zubon2003/c5-fpga-hdmi/hardware/tang25k_base/preview.png

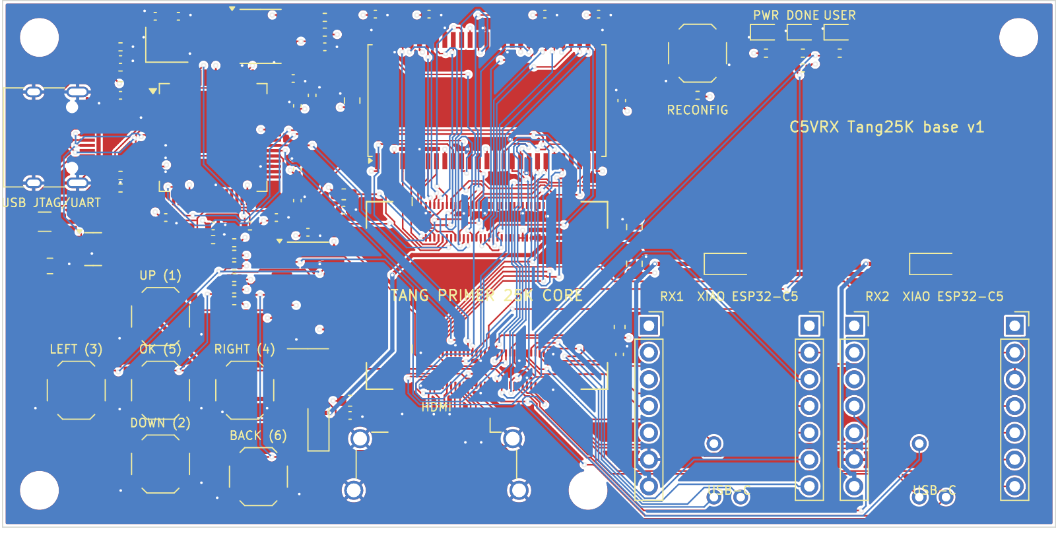
hardware/tang25k_base/preview.png
