zubon2003/c5-fpga-hdmi/hardware/tang25k_base/jlcpcb/tang25k_base_bom.csv

Comment | Designator | Footprint | LCSC
22uF | C1,C2 | C_0805_2012Metric | C45783
100nF | C3,C4,C5,C10,C11,C12,C13,C15,C23,C25,C26,C27,C28,C29,C30,C32,C33 | C_0402_1005Metric | C1525
10uF | C6,C14 | C_0805_2012Metric | C15850
27pF | C20,C21 | C_0402_1005Metric | C1557
4.7uF | C22,C24,C31 | C_0402_1005Metric | C23733
RB160M-30 | D1,D2,D3 | D_SOD-123 | C323857
green | D10,D11,D12 | LED_0603_1608Metric | C72043
1.5A PTC | F1 | Fuse_1206_3216Metric | C20802
600R@100MHz | FB1,FB2,FB3,FB4 | L_0603_1608Metric | C1015
DF40C-60DS-0.4V(51) | J1,J2 | Hirose_DF40C-60DS-0.4V_2x30_P0.4mm | C597938
TYPE-C-31-M-12 | J3 | USB_C_Receptacle_HRO_TYPE-C-31-M-12 | C165948
HDMI A | J4 | HDMI_A_Amphenol_10029449-x01xLF_Horizontal | C427307
5.1k | R1,R2,R5 | R_0402_1005Metric | C25905
12k 1% | R3 | R_0402_1005Metric | C25752
10k | R4,R7,R10,R11,R12,R13,R14,R15,R16,R22 | R_0402_1005Metric | C25744
2.2k | R6 | R_0402_1005Metric | C25879
1k | R20,R21,R23 | R_0402_1005Metric | C11702
TS-1187A | SW1,SW2,SW3,SW4,SW5,SW6,SW7 | SW_Push_1P1T_XKB_TS-1187A | C318884
FT2232HL | U1 | LQFP-64_10x10mm_P0.5mm | C27882
93LC56B | U2 | SOIC-8_3.9x4.9mm_P1.27mm | C183620
W9825G6KH-6I | U3 | TSOP-II-54_22.2x10.16mm_P0.8mm | C97572
74HC165 | U4 | SOIC-16_3.9x9.9mm_P1.27mm | C5613
USBLC6-2SC6 | U6 | SOT-23-6 | C7519
12MHz | Y1 | Crystal_SMD_3225-4Pin_3.2x2.5mm | C9002
