zubon2003/c5-fpga-hdmi/hardware/tang_primer_25k_dock_dimensions.pdf

## Tang Primer 25K Dock（60033）外形・取付穴

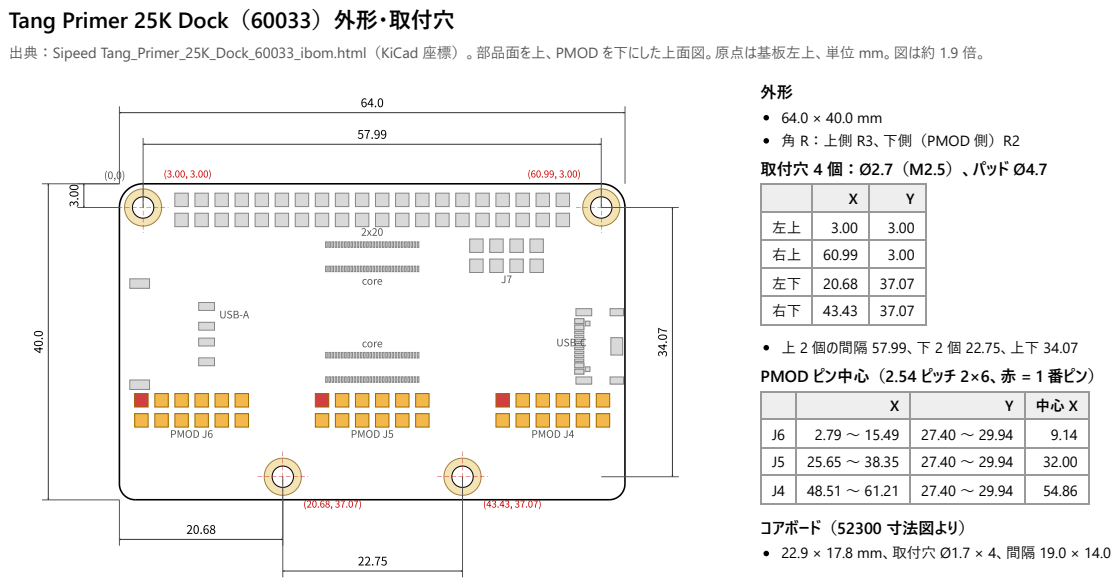
[picture p2: page 1]
core; PMOD J5; USB-C; PMOD J6; PMOD J4; USB-A

出典：Sipeed Tang_Primer_25K_Dock_60033_ibom.html（KiCad 座標）。部品面を上、PMOD を下にした上面図。原点は基板左上、単位 mm。図は約 1.9 倍。

角 R：上側 R3、下側（PMOD 側）R2
取付穴 4 個：Ø2.7（M2.5）、パッド Ø4.7

左上 | 3.00 | 3.00
右上 | 60.99 | 3.00
左下 | 20.68 | 37.07
右下 | 43.43 | 37.07

上 2 個の間隔 57.99、下 2 個 22.75、上下 34.07
PMOD ピン中心（2.54 ピッチ 2×6、赤 = 1 番ピン）

J6 | 2.79 〜 15.49 | 27.40 〜 29.94 | 9.14
J5 | 25.65 〜 38.35 | 27.40 〜 29.94 | 32.00
J4 | 48.51 〜 61.21 | 27.40 〜 29.94 | 54.86

コアボード（52300 寸法図より）
22.9 × 17.8 mm、取付穴 Ø1.7 × 4、間隔 19.0 × 14.0
