zubon2003/c5-fpga-hdmi/hardware/c5_pmod_carrier/c5_pmod_carrier.kicad_pcb

## KiCad design hardware/c5_pmod_carrier/c5_pmod_carrier.kicad_pcb (2026-11-01)

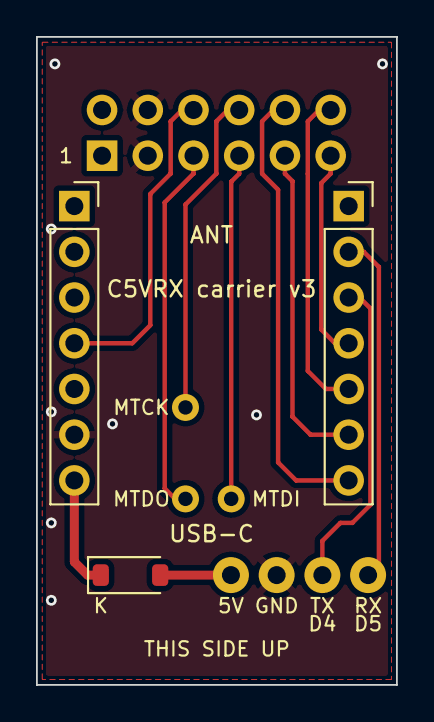
[picture p3: board c5_pmod_carrier.kicad_pcb from above]

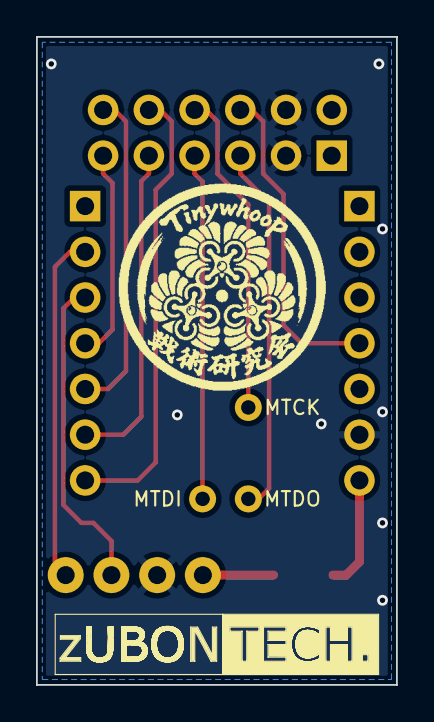
[picture p4: board c5_pmod_carrier.kicad_pcb from below]

Board: 2 copper layers, 20.0 x 36.0 mm, 13 parts (2 on the bottom side), 13 nets.

Parts:
D1: RB160M-30; D_SOD-123
J1: PMOD 2x6 R/A male; PMOD_2x06_RightAngle_Male
J2, J3: PinSocket_1x07_P2.54mm_Vertical
J4, J5, J6, J7: WirePad
LOGO1: LOGO_ZUBONTECH_RX5808v3_x2
LOGO2: LOGO; LOGO_TinywhoopLab_15mm
TP1, TP2, TP3: JTAGWireHole

Connections:
+5V_IN: D1.2, J7.1
C5_RX: J2.2, J4.1
C5_TX: J2.3, J5.1
GND: J1.3, J1.4, J3.6, J6.1
I0: J1.6, J3.4
I1: J1.5, TP1.1
I2: J1.7, TP2.1
IS: J1.8, TP3.1
Q0: J1.10, J2.7
Q1: J1.9, J2.6
Q2: J1.12, J2.5
QS: J1.11, J2.4
VBUS: D1.1, J3.7
