zubon2003/c5-fpga-hdmi/hardware/tang25k_base/tang25k_base.kicad_pcb

## KiCad design hardware/tang25k_base/tang25k_base.kicad_pcb (2026-11-01)

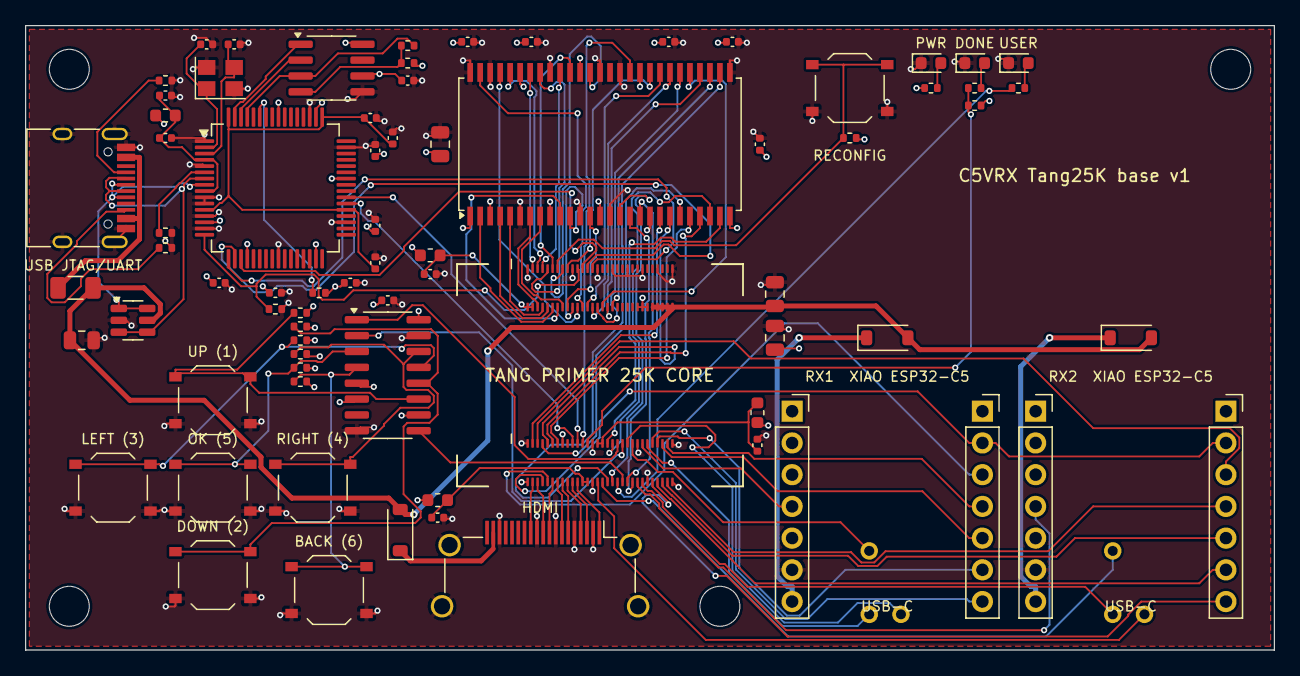
[picture p5: board tang25k_base.kicad_pcb from above]

Board: 4 copper layers, 100.0 x 50.0 mm, 87 parts (0 on the bottom side), 107 nets.

Parts:
C1, C2: 22uF; C_0805_2012Metric
C3, C4, C5, C10, C11, C12, C13, C15, C23, C25, C26, C27, C28, C29, C30, C32, C33: 100nF; C_0402_1005Metric
C6, C14: 10uF; C_0805_2012Metric
C20, C21: 27pF; C_0402_1005Metric
C22, C24, C31: 4.7uF; C_0402_1005Metric
D1, D2, D3: RB160M-30; D_SOD-123
D10, D11, D12: green; LED_0603_1608Metric
F1: 1.5A PTC; Fuse_1206_3216Metric
FB1, FB2, FB3, FB4: 600R@100MHz; L_0603_1608Metric
H1, H2, H3, H4: M3; MountingHole_3.2mm_M3
J1, J2: DF40C-60DS-0.4V(51); Hirose_DF40C-60DS-0.4V_2x30_P0.4mm
J3: TYPE-C-31-M-12; USB_C_Receptacle_HRO_TYPE-C-31-M-12
J4: HDMI A; HDMI_A_Amphenol_10029449-x01xLF_Horizontal
J5, J6, J7, J8: 1x7 socket; PinSocket_1x07_P2.54mm_Vertical
M1: Tang Primer 25K core; Tang_Primer_25K_core_outline
R1, R2, R5: 5.1k; R_0402_1005Metric
R3: 12k 1%; R_0402_1005Metric
R4, R7, R10, R11, R12, R13, R14, R15, R16, R22: 10k; R_0402_1005Metric
R6: 2.2k; R_0402_1005Metric
R20, R21, R23: 1k; R_0402_1005Metric
SW1, SW2, SW3, SW4, SW5, SW6, SW7: TS-1187A; SW_Push_1P1T_XKB_TS-1187A
TP11, TP12, TP13, TP21, TP22, TP23: WireHole
U1: FT2232HL; LQFP-64_10x10mm_P0.5mm
U2: 93LC56B; SOIC-8_3.9x4.9mm_P1.27mm
U3: W9825G6KH-6I; TSOP-II-54_22.2x10.16mm_P0.8mm
U4: 74HC165; SOIC-16_3.9x9.9mm_P1.27mm
U6: USBLC6-2SC6; SOT-23-6
Y1: 12MHz; Crystal_SMD_3225-4Pin_3.2x2.5mm

Connections:
+3V3: C2.1, C10.1, C11.1, C12.1, C13.1, C14.1, C15.1, C27.1, C28.1, C29.1, C30.1, C31.1, C32.1, C33.1, FB1.1, FB2.1, FB3.1, FB4.1, J2.46, J2.48, J2.50, R4.2, R7.2, R10.2, R11.2, R12.2, R13.2, R14.2, R15.2, R16.2, R20.1, R22.2, U1.14, U1.20, U1.31, U1.42, U1.50, U1.56, U2.6, U2.8, U3.1, U3.3, U3.9, U3.14, U3.27, U3.37, U3.43, U3.49, U4.5, U4.6, U4.10, U4.16
+5V: C1.1, C6.1, D1.2, D2.2, D3.2, F1.2, J2.52, J2.54, J2.56, J2.58, J2.60, U6.5
BTN1: R10.1, SW1.1, U4.11
BTN2: R11.1, SW2.1, U4.12
BTN3: R12.1, SW3.1, U4.13
BTN4: R13.1, SW4.1, U4.14
BTN5: R14.1, SW5.1, U4.3
BTN6: R15.1, SW6.1, U4.4
BTN_CLK: J1.39, U4.2
BTN_LD: J1.37, U4.1
BTN_Q: J1.40, U4.9
CC1: J3.A5, R1.1
CC2: J3.B5, R2.1
DONE: J1.25, R21.1, R22.1
EECLK: U1.62, U2.2
EECS: U1.63, U2.1
EEDATA: R6.2, U1.61, U2.3
EE_DO: R6.1, R7.1, U2.4
FT_PWRSAV: R4.1, U1.59
FT_REF: R3.1, U1.6
GND: C1.2, C2.2, C3.2, C4.2, C5.2, C6.2, C10.2, C11.2, C12.2, C13.2, C14.2, C15.2, C20.2, C21.2, C22.2, C23.2, C24.2, C25.2, C26.2, C27.2, C28.2, C29.2, C30.2, C31.2, C32.2, C33.2, D10.1, D11.1, D12.1, J1.1, J1.2, J1.15, J1.27, J1.28, J1.45, J1.50, J1.59, J1.60, J2.1, J2.19, J2.29, J2.35, J2.41, J2.47, J2.53, J2.59, J3.A1, J3.A12, J3.B1, J3.B12, J3.S1, J4.2, J4.5, J4.8, J4.11, J4.17, J4.SH, J6.6, J8.6, R1.2, R2.2, R3.2, R5.2, SW1.2, SW2.2, SW3.2, SW4.2, SW5.2, SW6.2, SW7.2, U1.1, U1.5, U1.10, U1.11, U1.13, U1.15, U1.25, U1.35, U1.47, U1.51, U2.5, U3.6, U3.12, U3.15, U3.19, U3.28, U3.39, U3.41, U3.46, U3.52, U3.54, U4.8, U4.15, U6.2, Y1.2, Y1.4
HDMI_5V: D3.1, J4.18
LED_DONE: D11.2, R21.2
LED_PWR: D10.2, R20.2
LED_USER: J1.38, R23.1
LED_USER_A: D12.2, R23.2
LINK_TX: J1.8, J5.2, J7.2
R1_I0: J1.47, J6.4
R1_I1: J1.49, TP11.1
R1_I2: J1.41, TP12.1
R1_IS: J1.43, TP13.1
R1_Q0: J1.51, J5.7
R1_Q1: J1.53, J5.6
R1_Q2: J1.55, J5.5
R1_QS: J1.57, J5.4
R1_TX: J1.10, J5.3
R1_VBUS: D1.1, J6.7
R2_I0: J1.46, J8.4
R2_I1: J1.48, TP21.1
R2_I2: J1.30, TP22.1
R2_IS: J1.32, TP23.1
R2_Q0: J1.52, J7.7
R2_Q1: J1.54, J7.6
R2_Q2: J1.56, J7.5
R2_QS: J1.58, J7.4
R2_TX: J1.5, J7.3
R2_VBUS: D2.1, J8.7
RECONFIG_N: J2.13, R16.1, SW7.1
SD_A0: J1.13, U3.23
SD_A1: J1.11, U3.24
SD_A2: J1.35, U3.25
SD_A3: J1.33, U3.26
SD_A4: J1.34, U3.29
SD_A5: J2.36, U3.30
SD_A6: J2.34, U3.31
SD_A7: J2.32, U3.32
SD_A8: J2.30, U3.33
SD_A9: J2.28, U3.34
SD_A10: J1.7, U3.22
SD_A11: J2.26, U3.35
SD_A12: J2.17, U3.36
SD_BA0: J1.3, U3.20
SD_BA1: J1.9, U3.21
SD_CAS: J1.44, U3.17
SD_CLK: J1.23, U3.38
SD_DQ0: J2.12, U3.2
SD_DQ1: J2.10, U3.4
SD_DQ2: J2.8, U3.5
SD_DQ3: J2.6, U3.7
SD_DQ4: J2.16, U3.8
SD_DQ5: J2.14, U3.10
SD_DQ6: J2.20, U3.11
SD_DQ7: J2.18, U3.13
SD_DQ8: J2.15, U3.42
SD_DQ9: J2.11, U3.44
SD_DQ10: J2.7, U3.45
SD_DQ11: J2.9, U3.47
SD_DQ12: J2.3, U3.48
SD_DQ13: J2.5, U3.50
SD_DQ14: J2.22, U3.51
SD_DQ15: J2.24, U3.53
SD_RAS: J1.42, U3.18
SD_WE: J1.36, U3.16
TCK: J2.21, R5.1, U1.16
TDI: J2.27, U1.17
TDO: J2.25, U1.18
TMDS0_N: J1.12, J4.9
TMDS0_P: J1.14, J4.7
TMDS1_N: J1.16, J4.6
TMDS1_P: J1.18, J4.4
TMDS2_N: J1.20, J4.3
TMDS2_P: J1.22, J4.1
TMDSC_N: J1.4, J4.12
TMDSC_P: J1.6, J4.10
TMS: J2.23, U1.19
UART_RXD: J1.19, U1.38
UART_TXD: J1.21, U1.39
USB_DM: J3.A7, J3.B7, U1.7, U6.3, U6.4
USB_DP: J3.A6, J3.B6, U1.8, U6.1, U6.6
V1V8: C24.1, C25.1, C26.1, U1.12, U1.37, U1.49, U1.64
VBUS: F1.1, J3.A4, J3.A9, J3.B4, J3.B9
VCCIO01: C3.1, FB1.2, J1.24, J1.26
VCCIO23: C5.1, FB3.2, J2.2, J2.4
VCCIO67: C4.1, FB2.2, J1.29, J1.31
VPHY: C22.1, C23.1, FB4.2, U1.4, U1.9
XI: C20.1, U1.2, Y1.1
XO: C21.1, U1.3, Y1.3
