zubon2003/c5-fpga-hdmi/src/display.v

// 1280x720 status display, three pipeline stages (74.18 MHz pixel clock):
//   y 0..479    waveform monitor of one demodulated line (scope_line):
//               1280 samples at 20 MS/s = 64 us across, 200 px = 10 us grid,
//               y = 240 - vid * 3 / 16, so 38.4 px per MHz
//   y 500..695  10 bars, 16 px high, 20 px apart:
//               rows 0..7 IQ pin n transitions per 12.4 ms / 512,
//               rows 8, 9 resampler early / late votes per 0.78 ms / 64
// The scope RAM is read with address x at stage 0, its data arrives with
// stage 1. Counts come from the IQ domain and are only displayed.
//
// Picture mode (pic_mode = 1) shows the decoded picture instead, scaled
// 240 -> 720 lines with vertical interpolation: field 1 line k is centred
// on output row 3k + 1, field 2 (half a field line lower) on 3k + 2.5, so
// the two fields no longer jump against each other (whole-line tripling
// left a 0.5 line jump between fields, seen as a regular 1-line jitter).
// Each stored pixel covers two output pixels, so the line buffer is read
// twice per stored pixel: the upper line A on even and the lower line B on
// odd x, one stored pixel ahead; the blend of the pair is ready after the
// odd read (the picture moves one output pixel right, which is harmless).
// Weights are sixths of a line, rounded to sixteenths.
// C = U on even and V on odd stored pixels.
// ar43 = 1 (4:3): 480 stored pixels on x 160..1119 (960 x 720), black
// pillars either side; ar43 = 0: 640 stored pixels stretched to 1280.
// RGB = Y + (1.125 V), Y - 0.39 U - 0.58 V, Y + 2 U (shift-add BT.601).
//
// Channel OSD: when the receiver link (c5_link.v) reports a new channel
// name, it is shown for 180 frames (3 s) at the top right, left of the
// lock marker: two 8x8 glyphs scaled 8x (64 px each, x 1112..1239,
// y 6..69) on a black box (x 1104..1243, y 0..75). The name comes from the
// IQ domain; it counts only after two frames with the same value, so a
// half-updated pair is never shown. "--" (no link yet) is not shown.
module display (
    input  wire               clk,
    input  wire [10:0]        x,
    input  wire [9:0]         y,
    input  wire               de,
    input  wire               hsync,
    input  wire               vsync,
    input  wire               line_start,
    input  wire [175:0]       activity,
    input  wire [15:0]        early_cnt,
    input  wire [15:0]        late_cnt,
    input  wire signed [13:0] sc_rd,
    input  wire               sc_trig,
    input  wire               pic_mode,
    input  wire               ar43,
    input  wire               parity,
    input  wire               bypass,       // genlock on: 24-line ring written by video_in (top.v)
    input  wire               color_on,
    input  wire               v_inv,
    input  wire [3:0]         sat,          // colour gain in quarters (4 = 1x)
    input  wire [4:0]         hue,          // colour rotation, 11.25 degree steps
    input  wire [15:0]        osd_name,     // receiver channel, two ASCII characters (IQ domain)
    output reg  [14:0]        pic_addr,
    input  wire [15:0]        pic,
    output reg  [23:0]        rgb,
    output reg                de_o,
    output reg                hsync_o,
    output reg                vsync_o
);
    // ---- per-line state: bar row and length ----
    reg [3:0]  r;
    reg [4:0]  p;
    reg [12:0] cnt;
    reg [10:0] len;
    wire in_bars = (y >= 500) && (r < 10) && (p < 16);

    always @(posedge clk) begin
        if (line_start) begin
            if (y == 500)    begin r <= 0;        p <= 0;        end
            else if (p == 19) begin r <= r + 4'd1; p <= 0;        end
            else                    p <= p + 5'd1;
        end
        if (x == 1) begin
            case (r)
                4'd0: cnt <= activity[  9 +: 13];
                4'd1: cnt <= activity[ 31 +: 13];
                4'd2: cnt <= activity[ 53 +: 13];
                4'd3: cnt <= activity[ 75 +: 13];
                4'd4: cnt <= activity[ 97 +: 13];
                4'd5: cnt <= activity[119 +: 13];
                4'd6: cnt <= activity[141 +: 13];
                4'd7: cnt <= activity[163 +: 13];
                4'd8: cnt <= {3'd0, early_cnt[15:6]};
                default: cnt <= {3'd0, late_cnt[15:6]};
            endcase
        end
        if (x == 2) len <= (cnt > 13'd1260) ? 11'd1260 : cnt[10:0];
    end

    // ---- picture: source lines and weight for this output line ----
    // position in sixths of a field line: 2y - 2 (field 1), 2y - 5 (field 2)
    // = 6 i + w, i the upper line (may be -1 at the top), w = 0..5.
    reg signed [9:0] li;
    reg [2:0]        lw;
    always @(posedge clk) begin
        if (line_start) begin
            if (y == 0) begin
                li <= -10'sd1;
                lw <= parity ? 3'd1 : 3'd4;
            end else if (lw >= 3'd4) begin
                li <= li + 10'sd1;
                lw <= lw - 3'd4;            // + 2 - 6
            end else begin
                lw <= lw + 3'd2;
            end
        end
    end
    wire [7:0] line_a = (li < 0) ? 8'd0 : (li > 10'sd239) ? 8'd239 : li[7:0];
    wire [7:0] line_b = (li < -10'sd1) ? 8'd0 : (li > 10'sd238) ? 8'd239 : li[7:0] + 8'd1;
    reg  [4:0] wb;                          // weight of B in sixteenths
    always @(*) begin
        case (lw)
            3'd0: wb = 5'd0;
            3'd1: wb = 5'd3;
            3'd2: wb = 5'd5;
            3'd3: wb = 5'd8;
            3'd4: wb = 5'd11;
            default: wb = 5'd13;
        endcase
    end
    // 160 is even, so the A / B and U / V parities of x stay the same.
    wire [10:0] xp       = ar43 ? x - 11'd160 : x;
    wire [10:0] px_last  = ar43 ? 11'd479 : 11'd639;
    wire [10:0] px_ahead = {1'b0, xp[10:1]} + 11'd1;
    wire [9:0]  px_rd    = (px_ahead > px_last) ? px_last[9:0] : px_ahead[9:0];
    // Output ring: 8 lines from sdram_fb, or 24 lines straight from video_in
    // when the output is genlocked (SDRAM bypass; slot = line mod 24).
    wire [7:0]  line_s = x[0] ? line_b : line_a;
    wire [7:0]  line_q = line_s / 8'd24;
    wire [4:0]  slot24 = line_s - {line_q[4:0], 3'd0} - {line_q[3:0], 4'd0};
    wire [4:0]  slot = bypass ? slot24 : {2'd0, line_s[2:0]};
    always @(*) pic_addr = {slot, 9'd0} + {2'd0, slot, 7'd0} + {5'd0, px_rd};   // slot * 640 + px

    // ---- channel OSD: change detection, once per frame ----
    reg [15:0] on_s1, on_s2, on_prev, on_shown;
    reg [7:0]  osd_t;                        // frames left to show
    reg        vs_d;
    always @(posedge clk) begin
        on_s1 <= osd_name;
        on_s2 <= on_s1;
        vs_d  <= vsync;
        if (vsync && !vs_d) begin
            on_prev <= on_s2;
            if (on_s2 == on_prev && on_s2 != on_shown) begin
                on_shown <= on_s2;
                osd_t    <= (on_s2 == "--") ? 8'd0 : 8'd180;
            end else if (osd_t != 0) begin
                osd_t <= osd_t - 8'd1;
            end
        end
    end
    function [7:0] font(input [7:0] c, input [2:0] row);   // 8x8, MSB = left
        reg [63:0] g;
        begin
            case (c)
                "0": g = 64'h3C666E7666663C00;  "1": g = 64'h1838181818187E00;
                "2": g = 64'h3C66060C30607E00;  "3": g = 64'h3C66061C06663C00;
                "4": g = 64'h0C1C3C6C7E0C0C00;  "5": g = 64'h7E607C0606663C00;
                "6": g = 64'h1C30607C66663C00;  "7": g = 64'h7E060C1830303000;
                "8": g = 64'h3C66663C66663C00;  "9": g = 64'h3C66663E060C3800;
                "A": g = 64'h183C66667E666600;  "B": g = 64'h7C66667C66667C00;
                "E": g = 64'h7E60607C60607E00;  "F": g = 64'h7E60607C60606000;
                "L": g = 64'h6060606060607E00;  "R": g = 64'h7C66667C6C666600;
                "-": g = 64'h0000007E00000000;
                default: g = 64'h0;
            endcase
            font = g[63 - 8 * row -: 8];
        end
    endfunction
    wire [10:0] ox = x - 11'd1112;           // glyph area, 2 x 64 px
    wire [9:0]  oy = y - 10'd6;
    wire        in_glyphs = (x >= 1112) && (x < 1240) && (y >= 6) && (y < 70);
    wire [7:0]  glyph_row = font(ox[6] ? on_shown[7:0] : on_shown[15:8], oy[5:3]);

    // ---- stage 1 ----
    reg [10:0] x1;
    reg [9:0]  y1;
    reg        de1, hs1, vs1, sc1, grid1, led1, bar1, mark1, obox1, obit1, pil1;
    reg [3:0]  r1;
    always @(posedge clk) begin
        x1    <= x;
        pil1  <= ar43 && ((x < 160) || (x >= 1120));
        y1    <= y;
        de1   <= de;
        hs1   <= hsync;
        vs1   <= vsync;
        r1    <= r;
        sc1   <= (y < 480);
        grid1 <= (y == 240) || (x == 200) || (x == 400) || (x == 600) ||
                 (x == 800) || (x == 1000) || (x == 1200);
        led1  <= (x >= 1248) && (x < 1268) && (y >= 8) && (y < 28);
        bar1  <= in_bars && (x >= 12) && (x < 12 + len);
        mark1 <= in_bars && (x < 10);
        obox1 <= (osd_t != 0) && (x >= 1104) && (x < 1244) && (y < 76);
        obit1 <= (osd_t != 0) && in_glyphs && glyph_row[3'd7 - ox[5:3]];
    end

    // ---- stage 2: trace position ----
    wire signed [15:0] v3  = sc_rd + (sc_rd <<< 1);
    wire signed [15:0] t_s = 16'sd240 - (v3 >>> 4);
    reg  [9:0] ty2, typ;
    reg  [9:0] y2;
    reg        de2, hs2, vs2, sc2, grid2, led2, bar2, mark2;
    reg  [3:0] r2;
    // Picture: pic belongs to x1 (A on even, B on odd x1). After the B read
    // the pair's blend is registered; U and V are held from the last even
    // and odd stored pixel (stored pixel x1 / 2 + 1, so even when x1[1] = 1).
    reg  [7:0]        a_y;
    reg  signed [7:0] a_c;
    reg  [4:0]        wb1;
    always @(posedge clk) begin
        wb1 <= wb;
        if (!x1[0]) begin
            a_y <= pic[15:8];
            a_c <= pic[7:0];
        end
    end
    wire [5:0]         wa1  = 6'd16 - {1'b0, wb1};
    wire [13:0]        y_bl = a_y * wa1 + pic[15:8] * wb1;
    wire signed [13:0] c_bl = a_c * $signed({1'b0, wa1}) + $signed(pic[7:0]) * $signed({2'b00, wb1});
    wire signed [7:0]  c_b8 = c_bl >>> 4;
    reg  [7:0]         yb;
    reg signed [7:0]   cu_l, cv_l;
    always @(posedge clk) begin
        if (x1[0]) begin
            yb <= y_bl[11:4];
            if (x1[1]) cu_l <= c_b8;
            else       cv_l <= v_inv ? -c_b8 : c_b8;
        end
    end
    // Hue rotation (cos / sin of hue * 11.25 degrees, 64 = 1), one stage.
    reg signed [7:0] hc, hs;
    always @(*) begin
        case (hue)
            5'd0: hc = 8'sd64;
            5'd1: hc = 8'sd63;
            5'd2: hc = 8'sd59;
            5'd3: hc = 8'sd53;
            5'd4: hc = 8'sd45;
            5'd5: hc = 8'sd36;
            5'd6: hc = 8'sd24;
            5'd7: hc = 8'sd12;
            5'd8: hc = 8'sd0;
            5'd9: hc = -8'sd12;
            5'd10: hc = -8'sd24;
            5'd11: hc = -8'sd36;
            5'd12: hc = -8'sd45;
            5'd13: hc = -8'sd53;
            5'd14: hc = -8'sd59;
            5'd15: hc = -8'sd63;
            5'd16: hc = -8'sd64;
            5'd17: hc = -8'sd63;
            5'd18: hc = -8'sd59;
            5'd19: hc = -8'sd53;
            5'd20: hc = -8'sd45;
            5'd21: hc = -8'sd36;
            5'd22: hc = -8'sd24;
            5'd23: hc = -8'sd12;
            5'd24: hc = 8'sd0;
            5'd25: hc = 8'sd12;
            5'd26: hc = 8'sd24;
            5'd27: hc = 8'sd36;
            5'd28: hc = 8'sd45;
            5'd29: hc = 8'sd53;
            5'd30: hc = 8'sd59;
            5'd31: hc = 8'sd63;
        endcase
        case (hue)
            5'd0: hs = 8'sd0;
            5'd1: hs = 8'sd12;
            5'd2: hs = 8'sd24;
            5'd3: hs = 8'sd36;
            5'd4: hs = 8'sd45;
            5'd5: hs = 8'sd53;
            5'd6: hs = 8'sd59;
            5'd7: hs = 8'sd63;
            5'd8: hs = 8'sd64;
            5'd9: hs = 8'sd63;
            5'd10: hs = 8'sd59;
            5'd11: hs = 8'sd53;
            5'd12: hs = 8'sd45;
            5'd13: hs = 8'sd36;
            5'd14: hs = 8'sd24;
            5'd15: hs = 8'sd12;
            5'd16: hs = 8'sd0;
            5'd17: hs = -8'sd12;
            5'd18: hs = -8'sd24;
            5'd19: hs = -8'sd36;
            5'd20: hs = -8'sd45;
            5'd21: hs = -8'sd53;
            5'd22: hs = -8'sd59;
            5'd23: hs = -8'sd63;
            5'd24: hs = -8'sd64;
            5'd25: hs = -8'sd63;
            5'd26: hs = -8'sd59;
            5'd27: hs = -8'sd53;
            5'd28: hs = -8'sd45;
            5'd29: hs = -8'sd36;
            5'd30: hs = -8'sd24;
            5'd31: hs = -8'sd12;
        endcase
    end
    // Saturation folded into the rotation coefficients (hue and sat are
    // quasi-static), so the pixel path has one multiply stage.
    wire signed [12:0] hcs_w = hc * $signed({1'b0, sat});
    wire signed [12:0] hss_w = hs * $signed({1'b0, sat});
    reg  signed [10:0] hcs, hss;            // 64 * 4 = 256 for 1x
    always @(posedge clk) begin
        hcs <= hcs_w > 13'sd1023 ? 11'sd1023 : hcs_w < -13'sd1023 ? -11'sd1023 : hcs_w[10:0];
        hss <= hss_w > 13'sd1023 ? 11'sd1023 : hss_w < -13'sd1023 ? -11'sd1023 : hss_w[10:0];
    end
    wire signed [19:0] ru_w = cu_l * hcs - cv_l * hss;
    wire signed [19:0] rv_w = cu_l * hss + cv_l * hcs;
    reg  signed [10:0] pu_c, pv_c;
    always @(posedge clk) begin
        pu_c <= (ru_w >>> 8) > 20'sd511 ? 11'sd511 : (ru_w >>> 8) < -20'sd511 ? -11'sd511 : ru_w[18:8];
        pv_c <= (rv_w >>> 8) > 20'sd511 ? 11'sd511 : (rv_w >>> 8) < -20'sd511 ? -11'sd511 : rv_w[18:8];
    end
    // RGB from the rotated chroma (stage 3; chroma is half resolution, so
    // its extra clock against luma does not matter).
    wire signed [9:0]  py = {2'b00, yb};
    wire signed [9:0]  pu = color_on ? pu_c[9:0] : 10'sd0;
    wire signed [9:0]  pv = color_on ? pv_c[9:0] : 10'sd0;
    wire signed [10:0] rr = py + pv + (pv >>> 3);
    wire signed [10:0] gg = py - (pu >>> 2) - (pu >>> 3) - (pv >>> 1) - (pv >>> 4);
    wire signed [10:0] bb = py + (pu <<< 1);
    function [7:0] clamp8(input signed [10:0] v);
        clamp8 = (v < 0) ? 8'd0 : (v > 11'sd255) ? 8'd255 : v[7:0];
    endfunction
    reg        pm2, obox2, obit2, pil2;
    always @(posedge clk) begin
        pm2   <= pic_mode;
        pil2  <= pil1;
        obox2 <= obox1;
        obit2 <= obit1;
        ty2   <= (t_s < 0) ? 10'd0 : (t_s > 16'sd479) ? 10'd479 : t_s[9:0];
        typ   <= ty2;
        y2    <= y1;
        de2   <= de1;
        hs2   <= hs1;
        vs2   <= vs1;
        sc2   <= sc1;
        grid2 <= grid1;
        led2  <= led1;
        bar2  <= bar1;
        mark2 <= mark1;
        r2    <= r1;
    end

    // ---- stage 3: colour ----
    wire [9:0] t_lo = (ty2 < typ) ? ty2 : typ;
    wire [9:0] t_hi = (ty2 < typ) ? typ : ty2;
    wire trace = (y2 >= t_lo) && (y2 <= t_hi);
    always @(posedge clk) begin
        de_o    <= de2;
        hsync_o <= hs2;
        vsync_o <= vs2;
        if (led2)                 rgb <= sc_trig ? 24'h20d040 : 24'hd03020;
        else if (obit2)           rgb <= 24'hffffff;
        else if (obox2)           rgb <= 24'h000000;
        else if (pm2 && pil2)     rgb <= 24'h000000;
        else if (pm2)             rgb <= {clamp8(rr), clamp8(gg), clamp8(bb)};
        else if (sc2 && trace)    rgb <= 24'hf0f070;
        else if (sc2 && grid2)    rgb <= 24'h303840;
        else if (sc2)             rgb <= 24'h0c1014;
        else if (bar2)
            case (r2)
                4'd3:    rgb <= 24'hff8000;   // Q sign
                4'd7:    rgb <= 24'h4080ff;   // I sign
                4'd8:    rgb <= 24'he04060;   // early votes
                4'd9:    rgb <= 24'h60c040;   // late votes
                default: rgb <= r2[2] ? 24'h00e0e0 : 24'he0e000;
            endcase
        else if (mark2)           rgb <= r2[3] ? 24'h404040 : r2[2] ? 24'h006060 : 24'h606000;
        else                      rgb <= 24'h000000;
    end
endmodule
