zubon2003/c5-fpga-hdmi/src/video_timing.v

// 1280x720p timing, 750 lines per frame always, positive syncs.
//
// Power-up (pclk): every line is BASE pixels and the loop below moves the
// pixel clock (PLL phase steps) instead of line lengths; HDZero goggles
// re-sync on any line length change. The porch-line method described
// next is still there as key 'g' mode 2.
//
// Genlock by line length: the frame must follow the input field (59.94 Hz)
// because the line ring holds only 16 lines. Repeating the last line until
// the input was ready (the first version) made frames 752..754 lines long;
// the capture card took that, but an HDMI monitor did not show the picture.
// Now the line count stays 750 and the line length moves instead:
//   BASE = 1650 pixels at 74.1818 MHz: 59.945 Hz, about the input's 59.94;
//   E pixels per frame (|E| <= 750) go into the five vertical front porch
//   lines (720..724, just before vsync), E / 5 each; all other lines are
//   exactly BASE. Spreading E one pixel per line over the whole frame made
//   the capture card shear the picture: it seems to place pixels by their
//   count from vsync at a fixed line length, so every longer line moved all
//   lines below it.
//   The line counter starts at the hsync, so a changed line length only
//   moves that line's front porch.
// Each `go` (input field ready) measures the phase p = how far the output
// frame is ahead of the wanted position (go at line TARGET, pixel 0), in
// pixels; e = p / 16; E = e + I, I += e / 16 (host simulation of this loop:
// peak error ~2.5 lines while locking, then within ~0.1 line). Two gos in a
// row more than JUMP lines off, or the first go after power-up, move the
// counters straight to TARGET once (one disturbed frame).
// Without go for 3 frames (input lost: top.v sends go for real fields
// only) the frame keeps running at the last frequency estimate (E = I) and
// stays locked, so a short loss of the input does not change the HDMI
// timing; unlocking there made the next go re-acquire every time, and the
// monitor blanked the picture for each (blackouts in flight).
module video_timing (
    input  wire        clk,
    input  wire        rst,
    input  wire        go,            // pulse: input field ready
    input  wire        pclk,          // genlock by the pixel clock (below)
    input  wire        free,          // genlock off: fixed 1650 x 750 frames
    output reg         ps_pulse,      // pclk: PLL CLKOUT0 phase steps
    output reg         ps_dir,
    output reg  [10:0] x,
    output reg  [9:0]  y,
    output reg         de,
    output reg         hsync,
    output reg         vsync,
    output reg         frame_start,
    output reg         line_start,
    output reg  [15:0] jumps          // re-acquisitions so far (status)
);
    localparam H_ACTIVE = 1280, H_SYNC = 40, H_BP = 220;     // front porch: the rest (110), CEA 720p
    localparam [10:0] H_START = H_SYNC + H_BP;                // first picture pixel: 260
    localparam V_ACTIVE = 720,  V_FP = 5,   V_SYNC = 5,  V_BP = 20;
    localparam [10:0] BASE    = 11'd1650;
    localparam [9:0]  V_TOTAL = V_ACTIVE + V_FP + V_SYNC + V_BP;   // 750
    localparam [9:0]  TARGET  = 10'd745;     // go 5 lines before the frame starts
    localparam [9:0]  JUMP    = 10'd8;

    reg [10:0] hc;
    reg [9:0]  vc;
    reg [10:0] h_last;                       // last pixel of this line
    reg signed [10:0] e_frame;               // E for the current frame
    reg signed [10:0] e_line;                // E / 5 for the porch lines
    reg signed [10:0] e_last;                // E - 4 (E / 5) for line 724
    reg signed [10:0] integ;
    reg [1:0]  since_go;                     // frames without a go, saturating at 3
    reg        locked;
    reg        stray;                        // the last go was far from TARGET

    // Phase of a go, computed over three clocks after it (once per frame):
    // lines from TARGET wrapped to -375..374, then pixels, then the loop.
    reg [9:0]  vc_go;
    reg [10:0] hc_go;
    reg [2:0]  ph;                           // pipeline stage valid bits
    reg signed [10:0] dv;
    reg signed [22:0] p_px;
    reg signed [22:0] p_prev;                // the field before (pclk)
    wire signed [10:0] dv_raw = $signed({1'b0, vc_go}) - $signed({1'b0, TARGET});
    // pclk: the two fields of a frame reach `go` half a line apart, and
    // that alternation made the pixel clock hop by ~100 ppm every field
    // (HDZero goggles flickered white). There the phase is the mean of the
    // last two fields and the gains are halved (e = p / 32, I += p / 512).
    wire signed [23:0] p_avg  = ($signed({p_px[22], p_px}) + $signed({p_prev[22], p_prev})) >>> 1;
    wire signed [18:0] e_w    = pclk ? p_avg >>> 5 : p_px >>> 4;
    wire signed [19:0] e_sum  = e_w + integ;
    wire signed [10:0] e_next = (e_sum > 20'sd750) ? 11'sd750 : (e_sum < -20'sd750) ? -11'sd750 : e_sum[10:0];
    wire signed [19:0] i_sum  = integ + (e_w >>> 4);
    // Starting frequency: pclk runs the PLL ~81 ppm fast (pll.v), about
    // E = 100 pixels per frame; kept over re-acquisitions.
    wire signed [10:0] I0     = pclk ? 11'sd100 : 11'sd0;
    wire signed [10:0] i_next = (i_sum > 20'sd750) ? 11'sd750 : (i_sum < -20'sd750) ? -11'sd750 : i_sum[10:0];
    // Cheap test at the go itself: close enough to TARGET to stay locked?
    wire near = (vc >= TARGET - JUMP) && (vc <= TARGET + JUMP);

    // E / 5 as E * 205 / 1024 (exact enough for |E| <= 750).
    wire signed [21:0] e5_w = e_frame * 11'sd205;
    wire signed [10:0] e5   = e5_w >>> 10;
    always @(posedge clk) begin
        e_line <= e5;
        e_last <= e_frame - (e5 <<< 2);
    end
    // Length of the next line: vc is the line that ends now, so the next
    // one is vc + 1.
    wire [9:0] vn = (vc == V_TOTAL - 1) ? 10'd0 : vc + 10'd1;
    // pclk: HDZero goggles re-acquire (flicker) on any change of a line
    // length, even BASE +- 1 for whole frames. Then every line stays BASE
    // and E moves the pixel clock instead: E pixels per frame are E * 80
    // dynamic phase steps of the TMDS clock (1/8 VCO period = 112.3 ps; a
    // pixel is 5 * 2 VCO periods, pll.v), spread evenly over the frame.
    wire signed [11:0] h_next = $signed({1'b0, BASE}) - 12'sd1 +
                                (pclk ? 11'sd0 :
                                 (vn >= 10'd720 && vn <= 10'd723) ? e_line :
                                 (vn == 10'd724)                  ? e_last : 11'sd0);

    always @(posedge clk) begin
        if (rst) begin
            hc <= 0; vc <= 0; h_last <= BASE - 11'd1;
            e_frame <= I0; integ <= I0;
            since_go <= 2'd3; locked <= 1'b0; jumps <= 0;
            ph <= 0; stray <= 1'b0;
        end else if (free) begin
            // fixed timing, no lock (key 'g'): the picture sits anywhere
            // and slowly rolls against the input
            e_frame <= 0; integ <= I0; locked <= 1'b0; ph <= 0; stray <= 1'b0;
            since_go <= 2'd3;
            if (hc == BASE - 11'd1) begin
                hc <= 0;
                h_last <= BASE - 11'd1;
                vc <= (vc == V_TOTAL - 1) ? 10'd0 : vc + 10'd1;
            end else begin
                hc <= hc + 11'd1;
            end
        end else if (go && (!locked || (!near && stray))) begin
            // (re)acquire: move straight to the wanted position
            vc <= TARGET; hc <= 0; h_last <= BASE - 11'd1;
            locked <= 1'b1; since_go <= 0; p_prev <= 0;
            if (!pclk) begin integ <= 0; e_frame <= 0; end
            else       e_frame <= integ;
            jumps <= jumps + 16'd1;
            ph <= 0; stray <= 1'b0;
        end else begin
            // A single go far from TARGET is ignored (no phase update); a
            // second one in a row re-acquires. Re-acquiring on every stray
            // go disturbed the picture several times a second on weak
            // signals.
            if (go) stray <= locked && !near;
            ph <= {ph[1:0], go && near};
            if (go) begin
                vc_go    <= vc;
                hc_go    <= hc;
                since_go <= 0;
            end
            if (ph[0]) dv   <= (dv_raw >= 11'sd375) ? dv_raw - 11'sd750 :
                               (dv_raw < -11'sd375) ? dv_raw + 11'sd750 : dv_raw;
            if (ph[1]) p_px <= dv * $signed({1'b0, BASE}) + $signed({1'b0, hc_go});
            if (ph[2]) begin
                e_frame <= e_next;           // takes effect from the next line
                integ   <= i_next;
                p_prev  <= p_px;
            end
            if (hc == h_last) begin
                hc <= 0;
                h_last <= h_next[10:0];
                if (vc == V_TOTAL - 1) begin
                    vc <= 0;
                    if (since_go == 2'd3) begin
                        e_frame <= integ;          // hold the frequency, stay locked
                    end else begin
                        since_go <= since_go + 2'd1;
                    end
                end else begin
                    vc <= vc + 10'd1;
                end
            end else begin
                hc <= hc + 11'd1;
            end
        end
    end

    // Phase step pulses: |E| * 80 per frame of BASE * 750 clocks, as a
    // rate accumulator; each step is 3 clocks high, 5 low.
    localparam [21:0] FRAME_PX = BASE * 750;
    // Only E > 0 is acted on: on the board PSDIR = 1 (decrease) moved the
    // clock the same way as 0, so the steps can only slow it down. The PLL
    // runs ~300 ppm fast (pll.v) and E stays positive in lock.
    wire [10:0] e_pos = e_frame[10] ? 11'd0 : e_frame;
    reg  [21:0] n_st;                            // E * 120 <= 90000
    always @(posedge clk) n_st <= {e_pos, 7'd0} - {e_pos, 3'd0};
    reg  [21:0] ps_acc /* synthesis syn_dspstyle = "logic" */;
    reg  [3:0]  ps_owed;
    reg  [2:0]  ps_cnt;
    wire        ps_due = (ps_acc + n_st >= FRAME_PX);
    always @(posedge clk) begin
        if (rst || !pclk || free) begin
            ps_acc <= 0; ps_owed <= 0; ps_cnt <= 0; ps_pulse <= 1'b0;
        end else begin
            ps_acc  <= ps_due ? ps_acc + n_st - FRAME_PX : ps_acc + n_st;
            if (ps_cnt != 0) begin
                ps_cnt   <= ps_cnt + 3'd1;
                ps_pulse <= (ps_cnt < 3'd3);
                ps_owed  <= ps_owed + {3'd0, ps_due};
            end else if (ps_owed != 0 || ps_due) begin
                ps_cnt   <= 3'd1;
                ps_pulse <= 1'b1;
                ps_dir   <= 1'b0;            // increase: later edges
                ps_owed  <= ps_owed + {3'd0, ps_due} - 4'd1;
            end
        end
    end

    // Registered outputs: one pixel of latency, same for every signal.
    always @(posedge clk) begin
        x           <= hc - H_START;    // picture coordinate (0..1279 while de)
        y           <= vc;
        de          <= (hc >= H_START) && (hc < H_START + H_ACTIVE) && (vc < V_ACTIVE);
        hsync       <= (hc < H_SYNC);
        vsync       <= (vc >= V_ACTIVE + V_FP) && (vc < V_ACTIVE + V_FP + V_SYNC);
        frame_start <= (hc == 0) && (vc == 0);
        line_start  <= (hc == 0);
    end
endmodule
