zubon2003/c5-fpga-hdmi/src/line_buffer.v

// LINES x 640 words of {Y, C} (address = line * 640 + pixel), one write
// and one read clock; read with one clock of latency. Used twice: the input
// ring (8 lines, video_in -> sdram_fb) and the output ring (24 lines,
// sdram_fb -> display, or video_in -> display with genlock on: top.v).
module line_buffer #(
    parameter LINES = 8
) (
    input  wire        wclk,
    input  wire        we,
    input  wire [14:0] waddr,
    input  wire [15:0] wdata,
    input  wire        rclk,
    input  wire [14:0] raddr,
    output reg  [15:0] rdata
);
    reg [15:0] mem [0:LINES * 640 - 1];
    always @(posedge wclk) if (we) mem[waddr] <= wdata;
    always @(posedge rclk) rdata <= mem[raddr];
endmodule
