zubon2003/c5-fpga-hdmi/(commit log)

2026-10-21 C5 GPIO IQ to HDMI on Tang Primer 25K: capture, resampler, FM demod
    - 720x480p DVI output on the Dock's PMOD DVI (J6), test pattern
    - IQ input on J4: IDES8 at 675 MS/s, phase-tracking resampler to the
    C5's 80 MHz MODEM_DIAG symbol rate (~30 ppm crystal offset tracked)
    - FM discriminator (phase LUT, adjacent difference, 16-tap boxcar),
    bit-exact against scripts/fm_model.py on the board
    - HDMI waveform monitor of one demodulated line, per-pin activity bars
    - UART logic analyser (raw / symbols / symbols + FM output) and host
    analysis scripts
    Adapts the MODEM_DIAG IQ GPIO routing and the external-DSP architecture
    research of C5VRX by Twotoz and the C5VRX contributors (see README).
    Co-Aut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
2026-10-21 720p output: 74.48 MHz pixel clock, pipelined status display
    - PLL CLKOUT0 = 1350 / 3.625 = 372.41 MHz (fractional ODIV0), pixel
    clock 74.48 MHz (+0.31 % against 74.25), 1280x720 at 60.19 Hz
    - display.v: waveform monitor (1280 samples at 20 MS/s per line) and
    activity / vote bars in three pipeline stages (Fmax 98 MHz)
    - scope_line: 1280 samples, decimation 4
    - test pattern removed
2026-10-21 Monochrome NTSC picture at 720p: sync separator, line sampler, genlock
    - video_in.v: slicing threshold half way between sync tip and back
    porch (averaged over lines); the min/max quarter fallback cut into
    dark picture parts under bright OSD text. Pulse width classes (H,
    equalising, broad), flywheel line starts, field start and parity,
    black / white normalisation, 1280 pixels per line into a 16-line ring
    - 720p output starts each frame when active line 0 of the input field
    is written (back porch held up to 8 extra lines); each field line is
    shown on 3 output lines
    - UART 'P' / 'W' switch between picture and waveform monitor
    - resampler: registered detector stage (clk_iq Fmax 117 M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
2026-10-21 Colour NTSC at 720p, viewer, status and chroma debug captures
    - chroma.v: subcarrier mixing of the raw discriminator output, 128-sample
    CIC low-pass, per-line burst on the back porch timed from the sync
    trailing edge, NCO frequency lock on the burst phase step, burst
    reference averaged over ~8 lines (ACC and hue)
    - video_in: 640 pixels per line as {Y, C}, chroma averaged over two field
    lines (cancels cross-colour), coring; sync slicing with 0.3 us
    hysteresis; learned levels reset after 26 ms without H sync
    - luma boxcar 22 (null at 3.64 MHz); fm_model.py follows
    - display: BT.601 RGB, V inverted by default (natural hues on the board),
    runtime saturation and hue, saturation folded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
    [chroma.v, display.v, fm_demod.v, fm_model.py, iq_la.v, line_buffer.v, top.v]
2026-10-21 Display-safe 720p genlock, 32-line ring, vertical interpolation
    - video_timing: always 750 lines of 1657 pixels; the input field lock
    (PI loop) only changes the five vertical front porch lines. Repeating
    the last line (752..754 lines per frame) worked on the capture card but
    not on an HDMI monitor; changing every line by one pixel sheared the
    picture on the capture card. Line counter starts at hsync.
    - Free-running output without input: 59.93 Hz.
    - Line ring 32 lines of 640 words (16 were overwritten at the bottom of
    the 720p frame: doubled OSD text).
    - Vertical interpolation, field 2 placed 1.5 output rows lower; two line
    buffer reads per stored pixel. Field offset direction mea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
2026-10-21 README in English: close-range warning, origins, hardware, wiring
    The Japanese development log moves to docs/DEVLOG.ja.md.
2026-10-22 Sync separator: line flywheel, integrated vsync, steadier output lock
    Line timing (src/video_in.v):
    - Line PLL with a +-2.5 us window around the prediction; eight H pulses
    in a row outside it re-acquire, 300 lines without a real H unlock.
    - While locked, lines start at the prediction instead of their own edge.
    A second-order loop in 1/256 sample compares each real H pulse centre
    (less the average half width) with the line start and corrects the
    next start by e/16 and the period by e/1024. This removes the visible
    horizontal wobble caused by edge noise (1.4 samples rms at close range,
    several times more on weaker signals).
    - The line grid idea follows the C5VRX-4 sync flywheel
    (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
    [measure.py, top.v, video_in.v, video_timing.v, viewer.py]
2026-10-22 FM demod PLL modes, colour killer, no output re-lock on lost input
    FM demodulator (src/fm_demod.v):
    - Amplitude-gated second-order phase-locked loop next to the original
    adjacent discriminator, selected with the 'm' key: mode 0 adjacent,
    1 PLL fast (kp 3/8, ki 1/32, power-up default), 2 PLL (1/4, 1/64),
    3 PLL slow (1/8, 1/128). The correction gain (0..1 in quarters) comes
    from the symbol's |z|^2 against its slow average, so 4-bit IQ near the
    origin barely moves the loop. The loop updates in one clock (a late
    correction cost ~3 dB SINAD in simulation) and runs in every mode, so
    switching is seamless; chroma still uses the adjacent step.
    - research/demod_sim.py: host study of the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
    [ab_demod.py, chroma.v, fm_demod.v, measure.py, top.v, video_in.v, video_timing.v]
2026-10-22 Receiver link: Dock buttons for band / channel, on-screen channel
    - src/c5_link.v: 115200 8N1 UART to the XIAO on Dock J5 (pin 5 = L5 TX
    to D5, pin 6 = K5 RX from D4). Key H11 sends 'b' (next band), H10 'c'
    (next channel), one per press with 20 ms debounce; '?' once at
    power-up. Parses the receiver's "CH <name> <MHz>" reports (CR / LF as
    8'h0d / 8'h0a: Gowin read "\r" as another character and dropped every
    report).
    - src/display.v: the new channel name for 180 frames (3 s) at the top
    right, 8x8 glyphs scaled 8x on a black box, after two frames with the
    same value; not shown before the first report.
    - Status packet: channel name in word 1, MHz in word 6, link bytes | last
    byte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
2026-10-27 Receiver link firmware for C5VRX-5 v5.0.523
    firmware/c5vrx5-v5.0.523-fpga-link.patch ports the UART link to C5VRX-5
    v5.0.523 and puts Q sign / I bit 0 back on D3/GPIO7 and D10/GPIO10:
    official releases from v5.0.482 on (C5VRX PR #263) route them to GPIO2
    and the user-LED GPIO27, which this wiring does not reach. The link is
    polled from the console task and starts after the receiver tasks, as a
    task of its own left the gain observer without heap at boot. Tested on
    the board: picture, on-screen channel and Dock buttons.
    The READMEs say which official releases still match the wiring and
    credit both patches.
    C5VRX by Twotoz and the C5VRX contributors, GPL-3.0-only.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
2026-10-27 demod_sim: compare with the C5's own U80P64-R1 demodulator
    --p64 <C5VRX>/main/p64_tables.h reads the C5VRX-5 v5.0.523 table from a
    C5VRX checkout (not copied here) and runs it as the C5 does: one update
    per pair of 40 MS/s samples, 16-sector phase token, codes over -6..+9 MHz.
    Clean tones come out within 0.05 MHz.
    NTSC, 10 MHz filter: the FPGA PLL modes hold 90 % H sync 2.5..3.4 dB
    lower in C/N than P64 at deviation 0.78 and 3.2..3.9 dB at 1.4; luma
    SINAD needs about the same C/N as mode 1 at 0.78 and 2.9 dB more at 1.4.
2026-10-27 4:3 picture: 960x720 with black pillars, 'A' toggles the 16:9 stretch
    The line sampler takes 480 pixels over the same 53.3 us (9 MS/s; Nyquist
    4.5 MHz, above the demodulator boxcar's 3.64 MHz null) instead of 640,
    and the display shows each at two output pixels from x = 160, so the
    vertical interpolation and U / V parity are unchanged. 4:3 at power-up;
    'A' (free in the FPGA and in viewer.py, where 'r' records) switches back
    to 640 pixels stretched to 1280. The HDMI timing stays 720p.
2026-10-28 Genlock by the pixel clock: fixed HDMI timing for HDZero goggles
    HDZero goggles (HDMI in) showed white with the input locked: they re-sync
    on any line length change, both the porch-line genlock and whole frames
    of BASE +- 1. The HDMI clock now comes from a second PLL (1100 MHz / 3,
    pixel 73.33 MHz, 1631 x 750) whose output takes dynamic phase steps
    (113.6 ps) at the rate the PI loop asks for, so the timing never changes.
    The integer divider matters: with the old 3.625 the phase wrapped after
    three VCO periods and the steps did not move the frequency.
    Key 'g' cycles genlock: pixel clock (power-up) / off / porch lines.
    [display.v, pll.v, top.v, video_timing.v, viewer.py]
2026-11-01 SDRAM field store, CEA 720p frame, link on USB-A, HDMI on J5
    - SDRAM field store (src/sdram_fb.v) in the Tang SDRAM module on the
    Dock 40-pin header: 4 field buffers between 8-line input and output
    rings, so the HDMI output runs on a fixed pixel clock (genlock off at
    power-up; HDZero goggles turn white on pixel clock phase steps).
    'K' / 'k' run the SDRAM read timing test (status word 13).
    - Output frame 1650 x 750 (CEA 720p) at 74.1818 MHz, from two integer
    PLLs in a row; HDZero goggles from 9.6.0-rc1 show black for the old
    1631 x 750 at 73.33 MHz.
    - Receiver link moved from PMOD J5 to the Dock USB-A host port J13:
    D+ = L6 (FPGA TX -> XIAO D5), D- = K6 (XIAO D4 -> FPGA RX); che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
    [c5_link.v, display.v, line_buffer.v, pll.v, sdram_fb.v, top.v, video_in.v]
2026-11-01 hardware: XIAO PMOD carrier and Tang Primer 25K core base board
    - c5_pmod_carrier: XIAO ESP32-C5 to Dock PMOD carrier (v3) with V-cut
    panel; second receiver on J6 now that the PMOD DVI is on J5.
    - tang25k_base: 100 x 50 mm four-layer base board for the 25K core
    (SDRAM, FT2232HL JTAG/UART, HDMI, two XIAO sockets, six buttons),
    routed, with JLCPCB Gerber/BOM/CPL. Not built or tested; the DF40
    pin order still has to be checked against Hirose's drawing.
    - Tang Primer 25K Dock dimension sheet (PDF).
    [c5_pmod_carrier.kicad_pcb, tang25k_base.kicad_pcb, tang25k_base_bom.csv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]
2026-11-01 Genlock without SDRAM, settings readback 'R', fuller PC test app
    - Genlock modes (pixel clock / porch) bypass the SDRAM: video_in writes
    a 24-line output ring directly, so they work without the SDRAM module
    and the latency drops to about 0.2-1 ms. BSRAM 41/56.
    - New UART command 'R' returns all settings (IQLR + 8 bytes).
    - scripts/viewer.py: capture device and UART port menus with auto
    reconnect, scaling and fullscreen, control panel, live status, and
    settings read back from the FPGA.
    - viewer.bat starts the viewer after checking its requirements.
    - Docs updated; drc.rpt no longer tracked.
    [display.v, iq_la.v, line_buffer.v, top.v, video_in.v, viewer.py]
2026-11-02 Save FPGA settings in the configuration flash; PLL slow at power-up
    - src/cfg_flash.v: SPI NOR access on the MSPI pins after configuration.
    The UART settings (all but P/W) are saved to the last 4 KB sector
    (0x7FF000) 2 s after the last change, read back to verify, and loaded
    at power-up; an empty or bad record keeps the power-up values
    - 'R' reply byte 7 is the save status (viewer.py: flash)
    - FM demodulator powers up in mode 3 (PLL slow) instead of 1
